conradtspang/MarineCollectionVessel/01_Documentation/07_MarineCollectionVessel_Electronics_Design.pdf

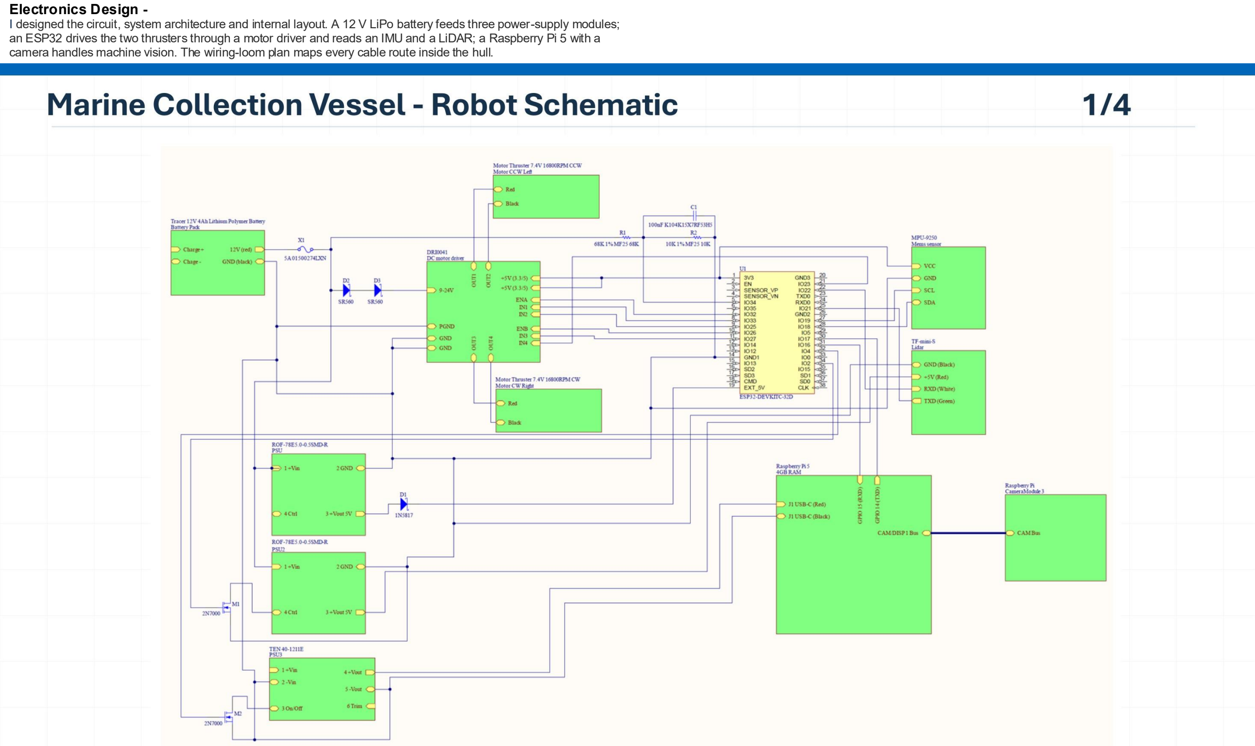
[picture p2: page 1]

Electronics Design -
I designed the circuit, system architecture and internal layout. A 12 V LiPo battery feeds three power-supply modules; an ESP32 drives the two thrusters through a motor driver and reads an IMU and a LiDAR; a Raspberry Pi 5 with a camera handles machine vision. The wiring-loom plan maps every cable route inside the hull.

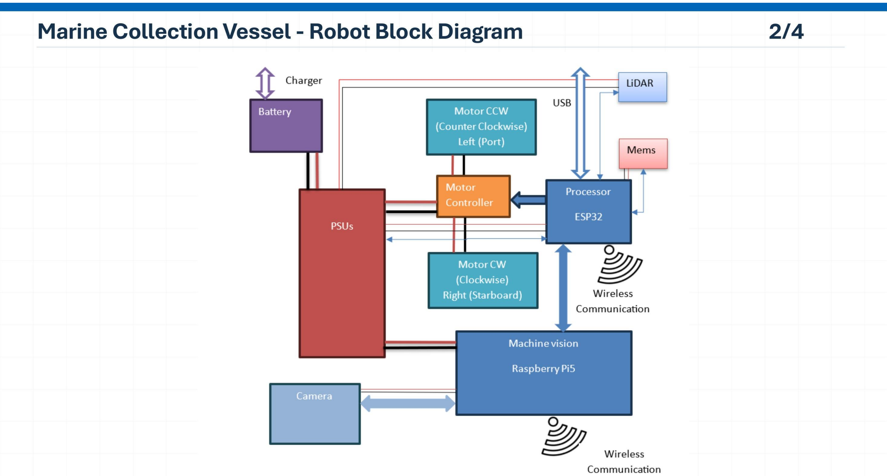
[picture p3: page 2]
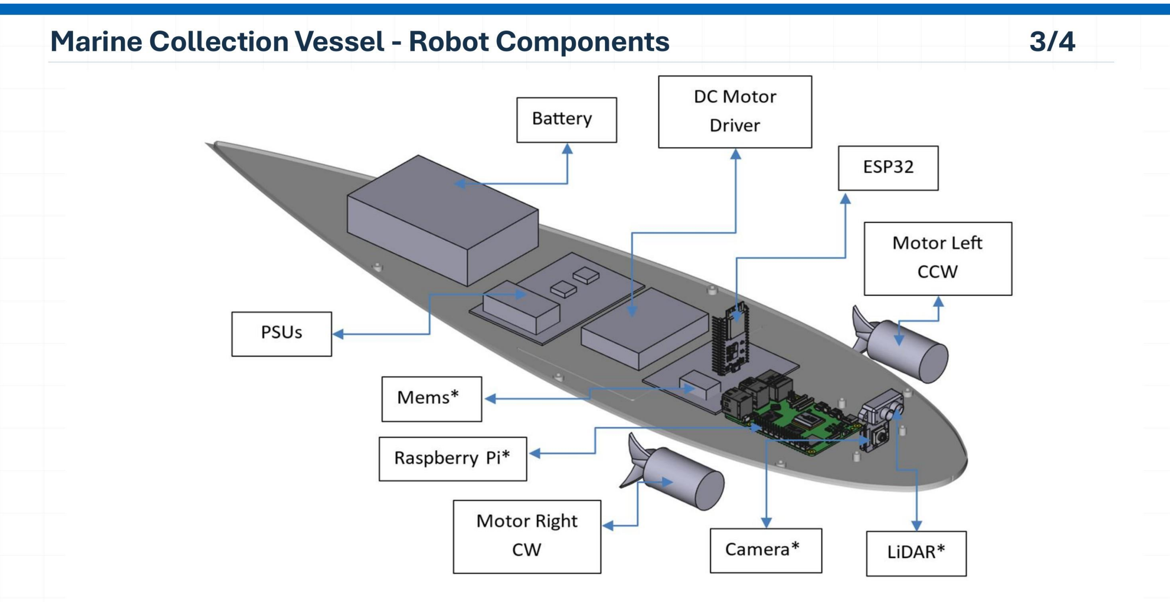
[picture p4: page 3]
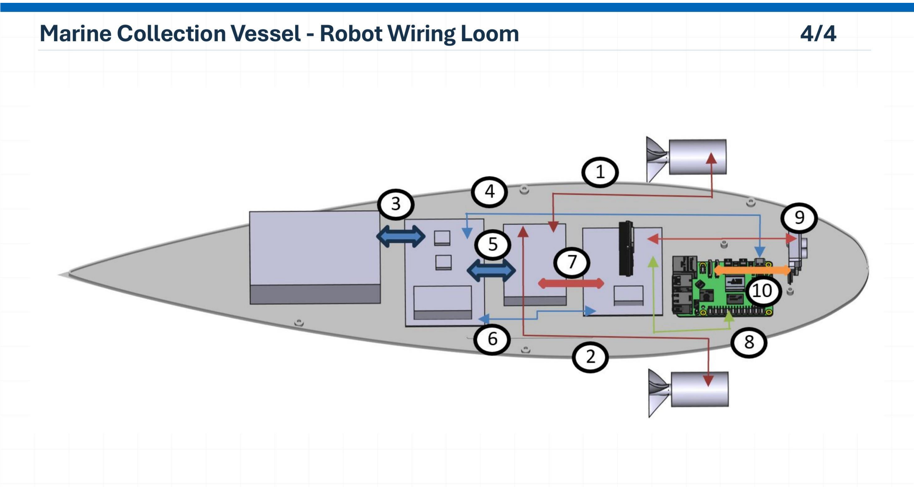
[picture p5: page 4]
