conradtspang/MarineCollectionVessel/03_Electronics/BOM.md

  <h1>Bill of materials</h1>
<center>
<table>
  <tr>
    <th>Part</th>
    <th>Model</th>
    <th>Qty</th>
    <th>Purpose</th>
  </tr>
  <tr>
    <td>Battery</td>
    <td>Tracer 12V 4Ah LiPo</td>
    <td>1</td>
    <td>Main power</td>
  </tr>
  <tr>
    <td>Fuse</td>
    <td>5A</td>
    <td>1</td>
    <td>Battery protection</td>
  </tr>
  <tr>
    <td>Diode</td>
    <td>SR560</td>
    <td>2</td>
    <td>Reduce voltage for motor driver</td>
  </tr>
 <tr>
    <td>Motor driver</td>
    <td>DRV8841 dual DC motor driver</td>
    <td>1</td>
    <td>Drives both thrusters</td>
  </tr>
  <tr>
    <td>Microcontroller</td>
    <td>ESP32 DevKit V1</td>
    <td>1</td>
    <td>Vessel control, ESP-NOW</td>
  </tr>
    <tr>
    <td>PSU</td>
    <td>ROF-78E5.0-0.5SMD-R</td>
    <td>2</td>
    <td>5V supply rails</td>
  </tr>
      <tr>
    <td>Shortky Diode</td>
    <td>1N5817</td>
    <td>1</td>
    <td>Protect PSU from USB voltage</td>
  </tr>
    <tr>
    <td>PSU</td>
    <td>TEN40-1211E</td>
    <td>1</td>
    <td>Raspberry Pi supply (phase 2)</td>
  </tr>
    <tr>
    <td>MOSFET</td>
    <td>2N7000</td>
    <td>2</td>
    <td>Switch power rails on/off</td>
  </tr>
      <tr>
    <td>Resistor</td>
    <td>68k</td>
    <td>1</td>
    <td>Divider bridge to monitor battery voltage</td>
  </tr>
      <tr>
    <td>Resistor</td>
    <td>10k</td>
    <td>1</td>
    <td>Divider bridge to monitor battery voltage</td>
  </tr>
      <tr>
    <td>Capacitor</td>
    <td>100nF</td>
    <td>2</td>
    <td>Low pass filter to monitor battery voltage</td>
  </tr>
    <tr>
    <td>Thrusters</td>
    <td>7.4V 16800 RPM,3-blade (1 CW, 1CCW)</td>
    <td>2</td>
    <td>Propulsion</td>
  </tr>
    <tr>
    <td>Remote controller</td>
    <td>pyController</td>
    <td>1</td>
    <td>Handheld control</td>
  </tr>
   <tr>
    <td colspan="4"><b>Phase 2 (planned)</b></td>

  </tr>
      <tr>
    <td>LiDAR</td>
    <td>TFmini-S</td>
    <td>1</td>
    <td>Obstacle detection</td>
  </tr>
        <tr>
    <td>IMU</td>
    <td>MPU-9250</td>
    <td>1</td>
    <td>Heading and orientation</td>
  </tr>
          <tr>
    <td>Vision processor</td>
    <td>Raspberry Pi 5, 4GB</td>
    <td>1</td>
    <td>YOLO detection</td>
  </tr>
          <tr>
    <td>Camera</td>
    <td>Raspberry Pi Camera Module 3</td>
    <td>1</td>
    <td>Video capture</td>
  </tr>
</table>
</center>
