conradtspang/MarineCollectionVessel/02_3D_Print_Files/Lattice_Box/no.20-1012503_3 Latticebox-05 FrontCornerLeft.15.12.25.stl

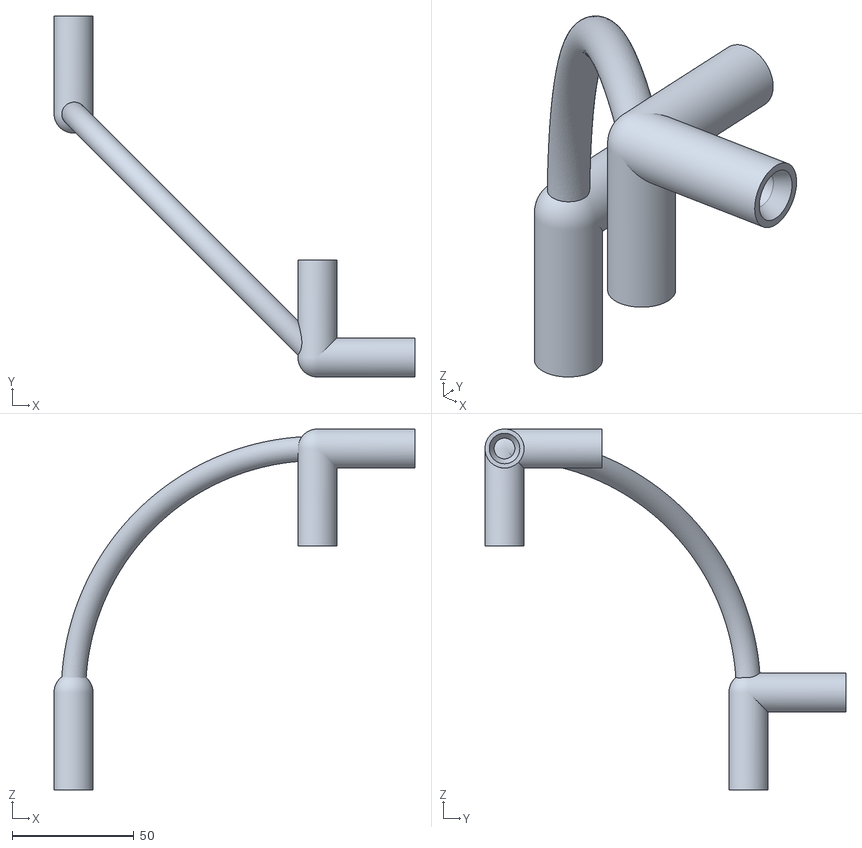
[picture p6: CAD file, 2026-09-25]
02_3D_Print_Files/Lattice_Box/no.20-1012503_3 Latticebox-05 FrontCornerLeft.15.12.25.stl
148.0 x 148.0 x 148.0
