conradtspang/MarineCollectionVessel/02_3D_Print_Files/Net/no.14-1012503 Robot Mod Rev1.10-15NetAttachment.15.12.25.stl

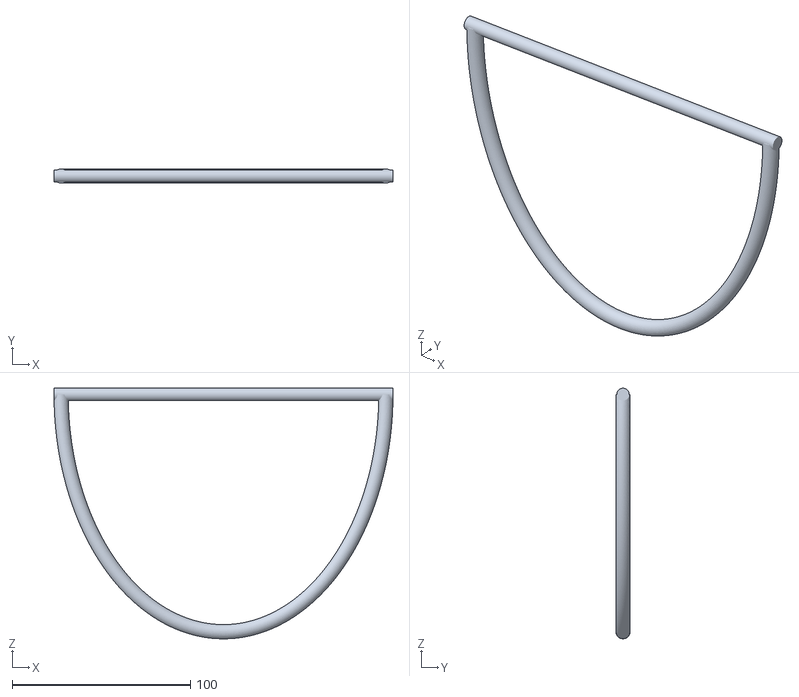
[picture p7: CAD file, 2026-09-25]
02_3D_Print_Files/Net/no.14-1012503 Robot Mod Rev1.10-15NetAttachment.15.12.25.stl
190.0 x 8.00 x 140.5
