conradtspang/MarineCollectionVessel/02_3D_Print_Files/no.13-1012503 Robot Mod Rev1.20-14Mouth.15.12.25.stl

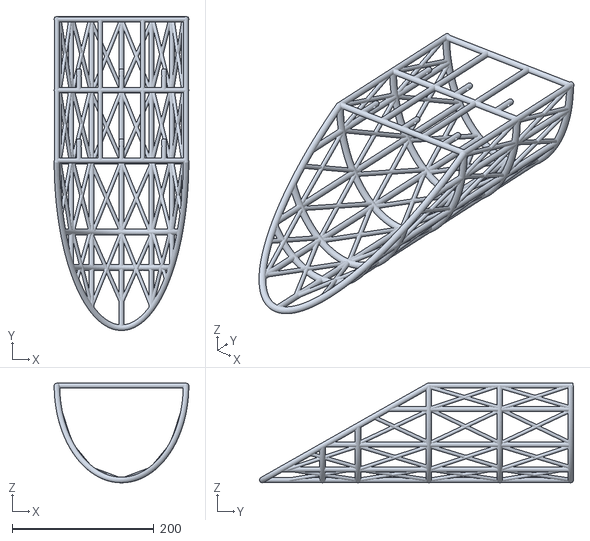
[picture p8: CAD file, 2026-09-25]
02_3D_Print_Files/no.13-1012503 Robot Mod Rev1.20-14Mouth.15.12.25.stl
190.0 x 443.0 x 140.5
