conradtspang/MarineCollectionVessel/02_3D_Print_Files/Lattice_Box/no.21-1012503_3 Latticebox-06 FrontBottomCornerRight.15.12.25.stl

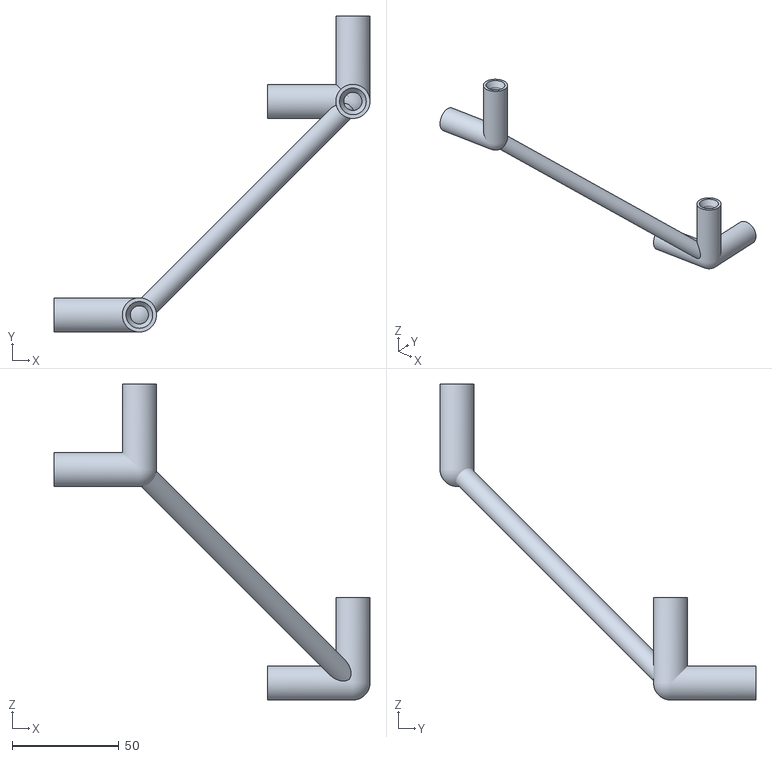
[picture p9: CAD file, 2026-09-25]
02_3D_Print_Files/Lattice_Box/no.21-1012503_3 Latticebox-06 FrontBottomCornerRight.15.12.25.stl
148.0 x 148.0 x 148.0
