conradtspang/MarineCollectionVessel/02_3D_Print_Files/no.11-1012503 Robot Mod Rev1.10-12SupportL.15.12.25.stl

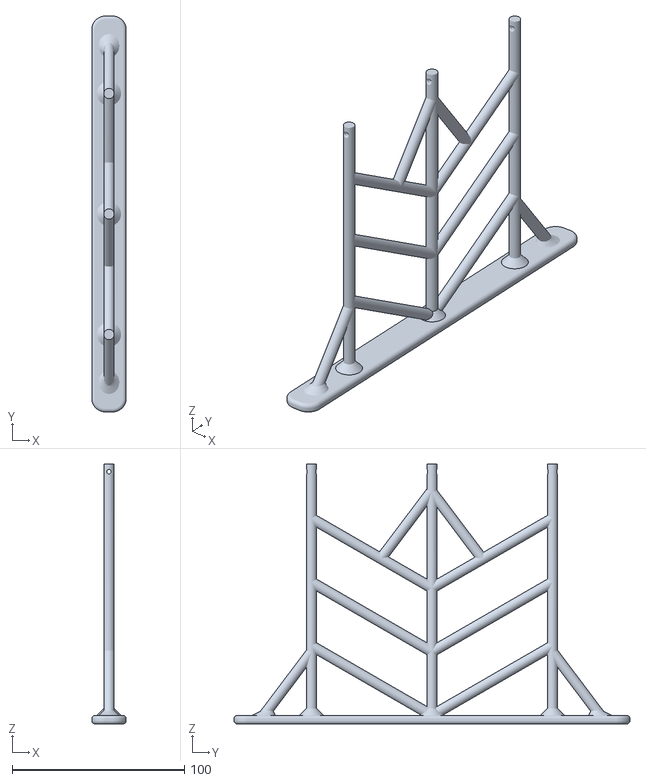
[picture p10: CAD file, 2026-09-25]
02_3D_Print_Files/no.11-1012503 Robot Mod Rev1.10-12SupportL.15.12.25.stl
20.0 x 230.0 x 151.0
