conradtspang/MarineCollectionVessel/02_3D_Print_Files/Lattice_Box/no.23-1012503_3 Latticebox-08 CornerX2.15.12.25.stl

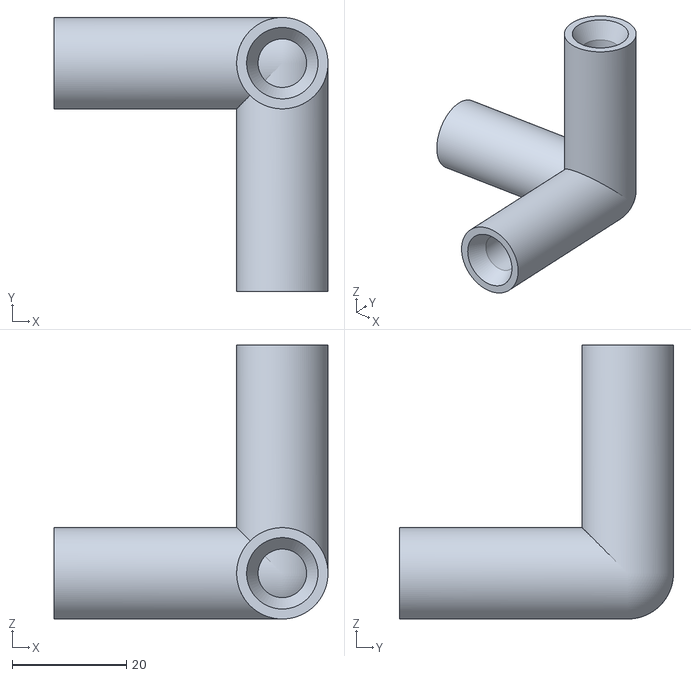
[picture p11: CAD file, 2026-09-25]
02_3D_Print_Files/Lattice_Box/no.23-1012503_3 Latticebox-08 CornerX2.15.12.25.stl
48.0 x 48.0 x 48.0
