conradtspang/MarineCollectionVessel/02_3D_Print_Files/no.10-1012503 Robot Mod Rev1.0-11FloatBottomR.15.12.25.stl

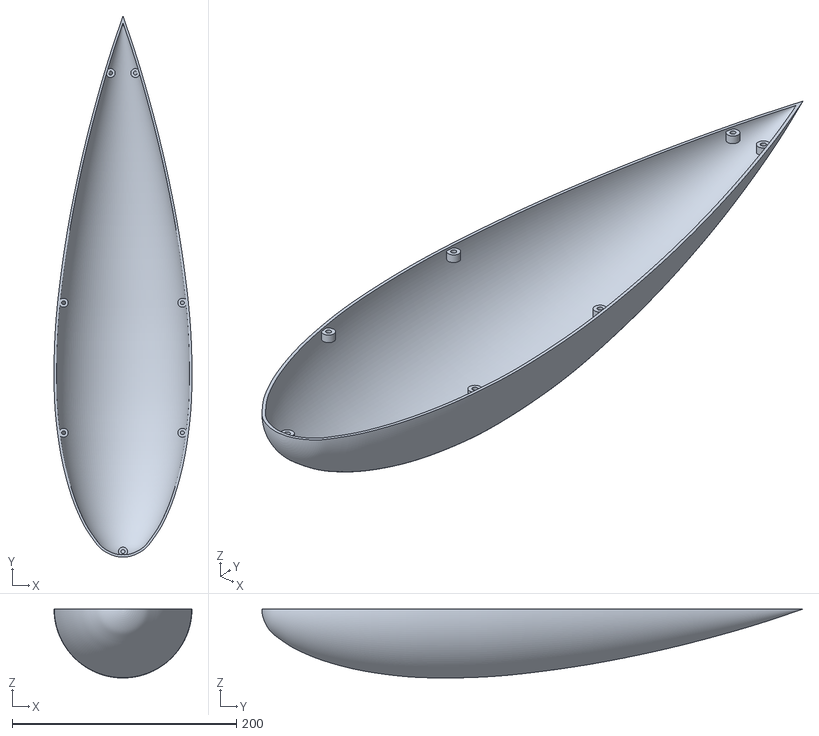
[picture p12: CAD file, 2026-09-25]
02_3D_Print_Files/no.10-1012503 Robot Mod Rev1.0-11FloatBottomR.15.12.25.stl
123.1 x 482.7 x 61.6
