conradtspang/MarineCollectionVessel/02_3D_Print_Files/no.08-1012503 Robot Mod Rev1.0-09FloatTopR.15.12.25.stl

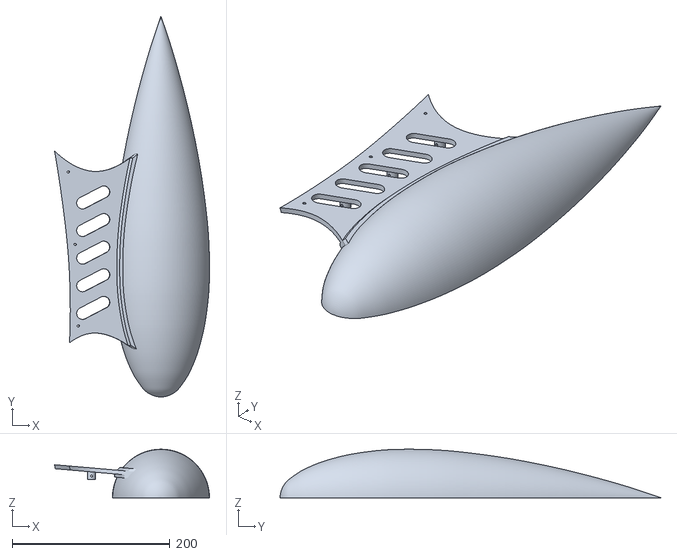
[picture p13: CAD file, 2026-09-25]
02_3D_Print_Files/no.08-1012503 Robot Mod Rev1.0-09FloatTopR.15.12.25.stl
196.5 x 482.7 x 61.6
