conradtspang/MarineCollectionVessel/02_3D_Print_Files/no.06-1012503 Robot Mod Rev1.0-07MotorR.15.12.25.stl

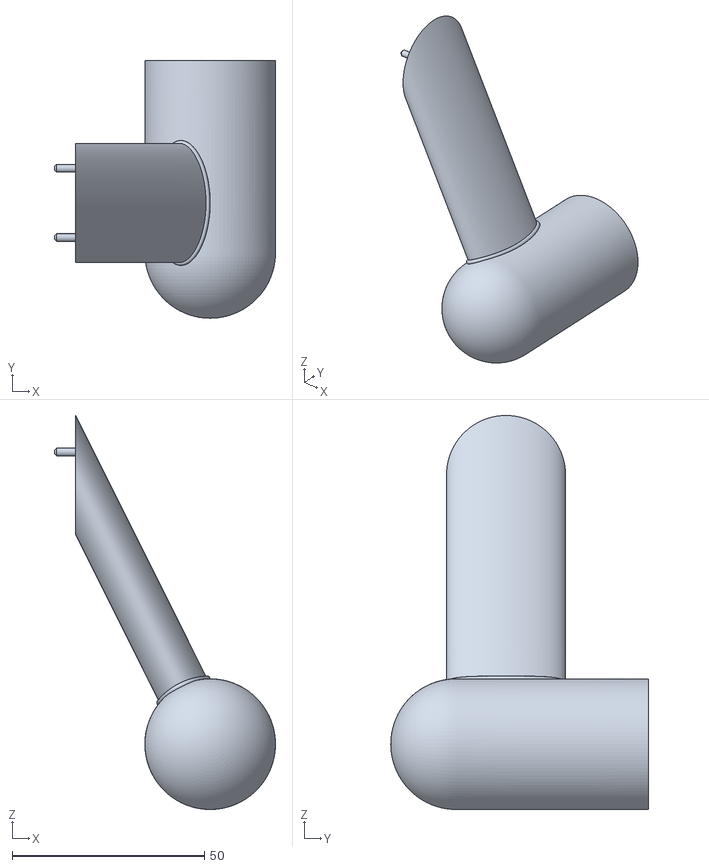
[picture p14: CAD file, 2026-09-25]
02_3D_Print_Files/no.06-1012503 Robot Mod Rev1.0-07MotorR.15.12.25.stl
57.5 x 67.0 x 102.5
