conradtspang/MarineCollectionVessel/02_3D_Print_Files/Lattice_Box/no.24-1012503_3 Latticebox-09 MiddleX2.15.12.25.stl

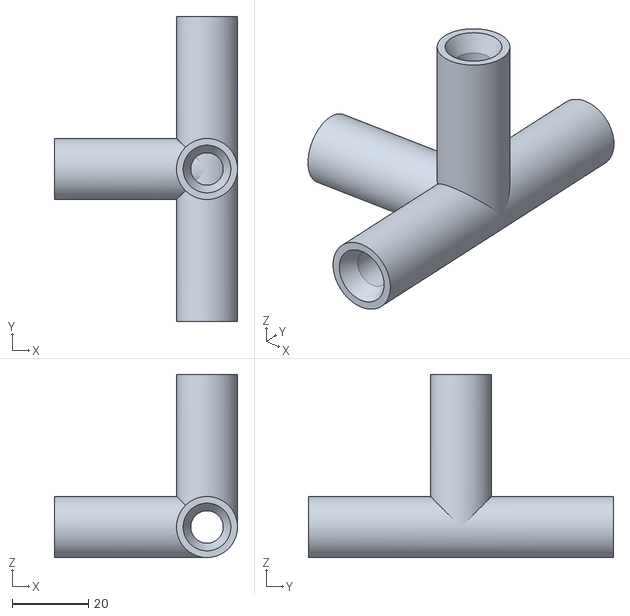
[picture p15: CAD file, 2026-09-25]
02_3D_Print_Files/Lattice_Box/no.24-1012503_3 Latticebox-09 MiddleX2.15.12.25.stl
48.0 x 80.0 x 48.0
