conradtspang/MarineCollectionVessel/02_3D_Print_Files/no.04-1012503 Robot Mod Rev1.10-05BottomPlate.15.12.25.stl

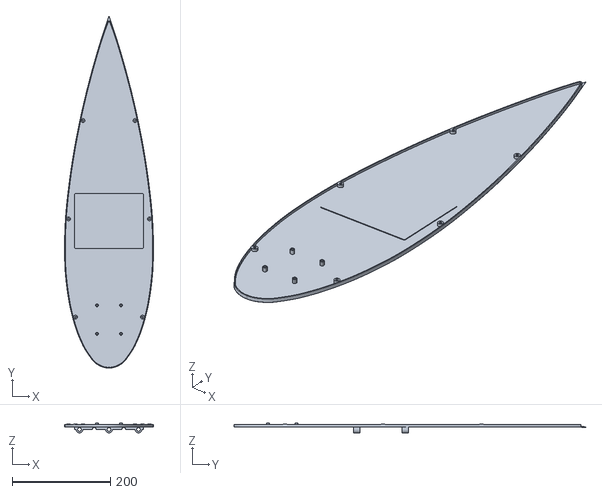
[picture p17: CAD file, 2026-09-25]
02_3D_Print_Files/no.04-1012503 Robot Mod Rev1.10-05BottomPlate.15.12.25.stl
181.0 x 716.8 x 20.0
