conradtspang/MarineCollectionVessel/02_3D_Print_Files/Lattice_Box/no.15-1012503 Robot Mod Rev1.20-16LatticeBoxAttatchment.15.12.25.stl

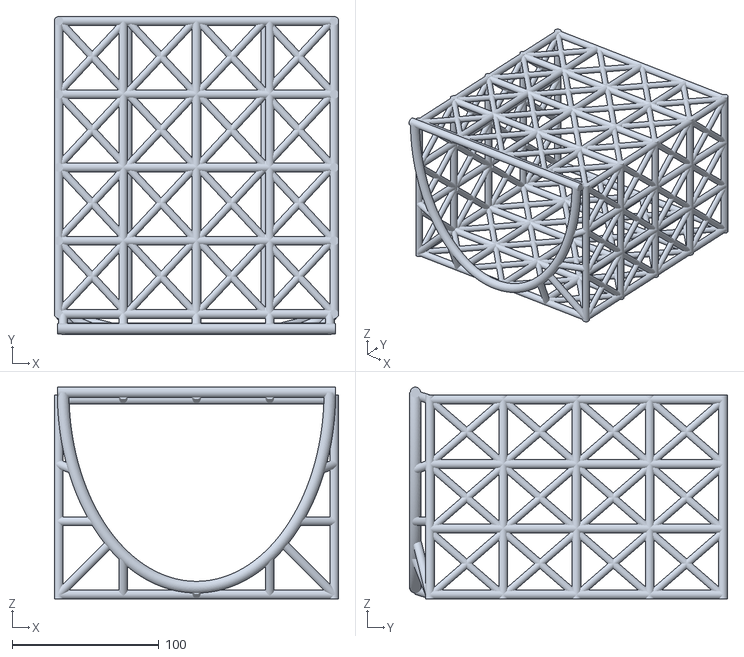
[picture p18: CAD file, 2026-09-25]
02_3D_Print_Files/Lattice_Box/no.15-1012503 Robot Mod Rev1.20-16LatticeBoxAttatchment.15.12.25.stl
194.0 x 217.0 x 144.5
