conradtspang/MarineCollectionVessel/02_3D_Print_Files/no.03-1012503 Robot Mod Rev1.0-04see_through_panel.15.12.25.stl

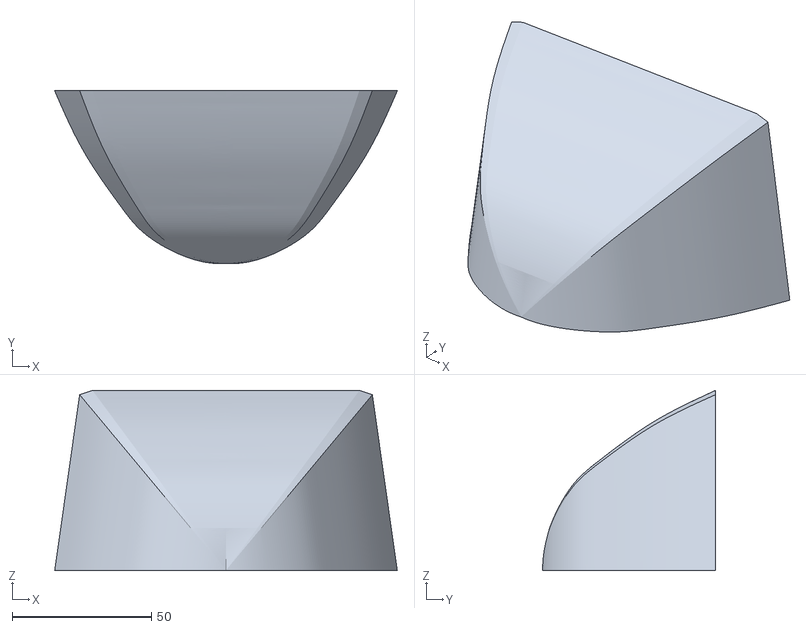
[picture p19: CAD file, 2026-09-25]
02_3D_Print_Files/no.03-1012503 Robot Mod Rev1.0-04see_through_panel.15.12.25.stl
123.1 x 62.1 x 64.7
