conradtspang/MarineCollectionVessel/02_3D_Print_Files/no.02-1012503 Robot Mod Rev1.0-03Housing.15.12.25.stl

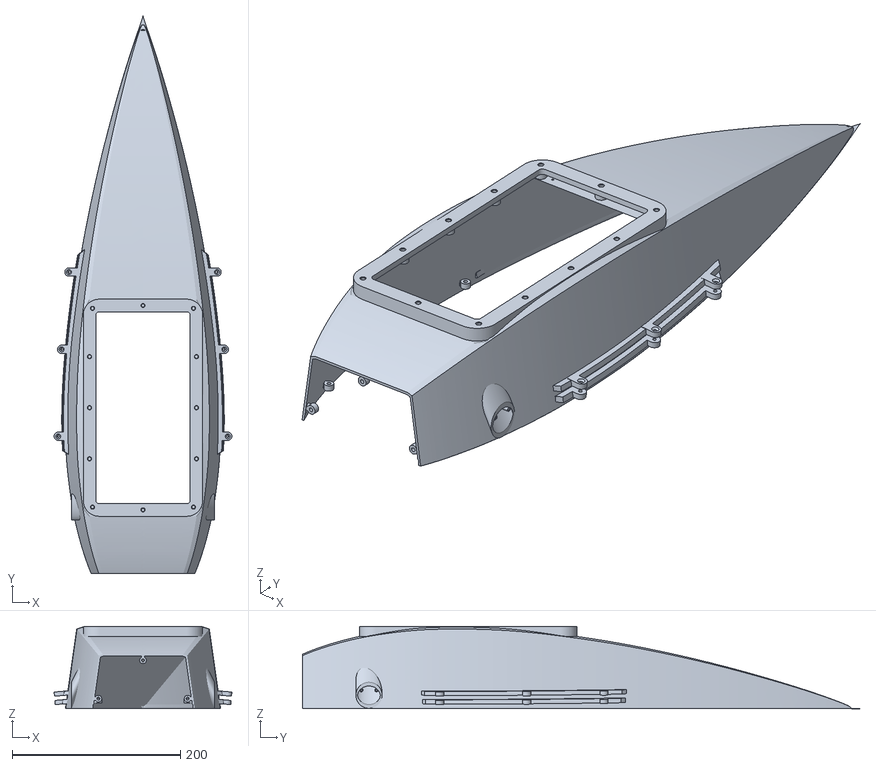
[picture p20: CAD file, 2026-09-25]
02_3D_Print_Files/no.02-1012503 Robot Mod Rev1.0-03Housing.15.12.25.stl
211.4 x 661.9 x 98.0
