conradtspang/MarineCollectionVessel/02_3D_Print_Files/no.01-1012503 Robot Mod Rev1.0-01Lid.15.12.25.stl

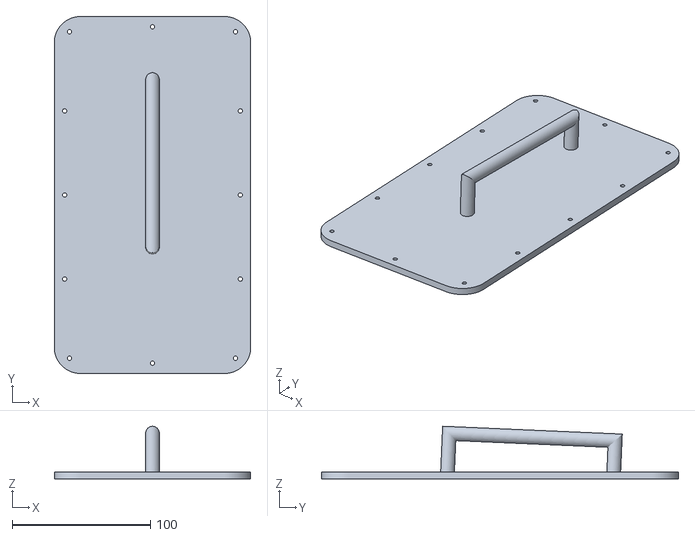
[picture p21: CAD file, 2026-09-25]
02_3D_Print_Files/no.01-1012503 Robot Mod Rev1.0-01Lid.15.12.25.stl
142.0 x 258.0 x 38.0
