conradtspang/MarineCollectionVessel/(list of files, cad)

Other CAD files:
02_3D_Print_Files/Lattice_Box/no.16-1012503_3 Latticebox-01 EndCornerRight.15.12.25.stl
02_3D_Print_Files/no.09-1012503 Robot Mod Rev1.0-10FloatBottomL.15.12.25.stl
02_3D_Print_Files/Lattice_Box/no.19-1012503_3 Latticebox-04 FrontCornerRight.15.12.25.stl
02_3D_Print_Files/Lattice_Box/no.22-1012503_3 Latticebox-07 FrontBottomCornerLeft.15.12.25.stl
02_3D_Print_Files/no.07-1012503 Robot Mod Rev1.0-08FloatTopL.15.12.25.stl
02_3D_Print_Files/Lattice_Box/no.17-1012503_3 Latticebox-02 EndCornerLeft.15.12.25.stl
02_3D_Print_Files/no.05-1012503 Robot Mod Rev1.0-06MotorL.15.12.25.stl
