conradtspang/MarineCollectionVessel/02_3D_Print_Files/README.md

<div align="center">
    <h1>Marine Collection Vessel 3D Print Files</h1>
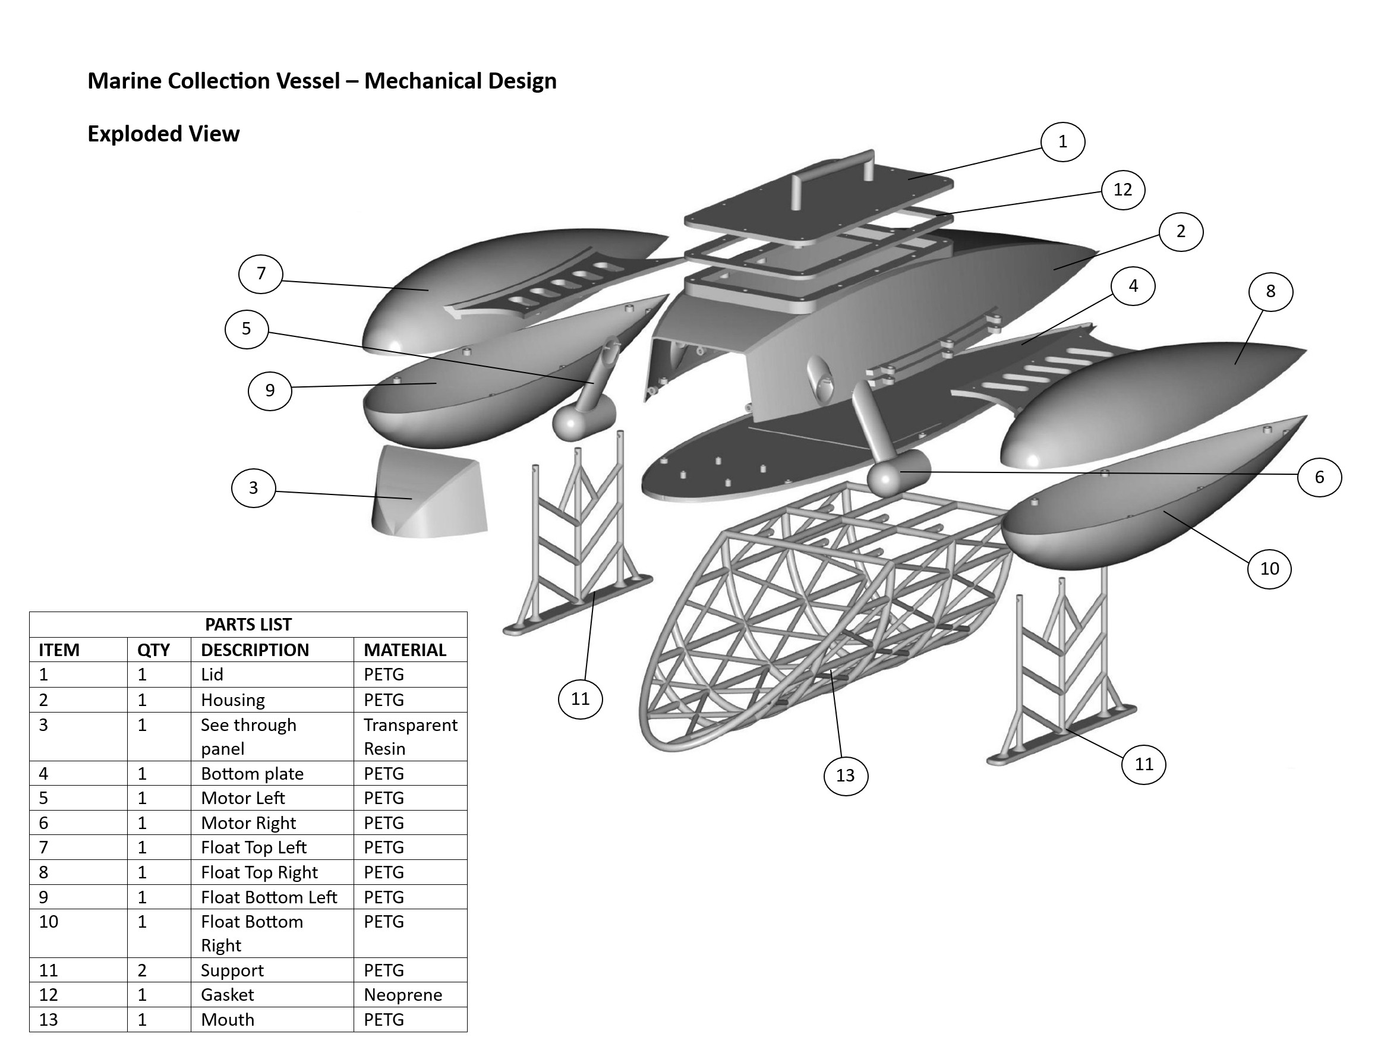
[picture p22: 02_3D_Print_Files/MarineCollectionVesselExplodedView.jpg]
Marine Collection Vessel Exploded view
  

</div>
