conradtspang/MarineCollectionVessel/(commit log)

2026-09-25 Rename no.01-1012503 Robot Mod Rev1.0-01Lid.15.12.25.stl to 02_3D_Print_Files/no.01-1012503 Robot Mod Rev1.0-01Lid.15.12.25.stl
    Lid of the Marine Collection Vessel
    Material: PETG
    Infull: 100% need to be waterproof
    Colour: Light Grey
    [no.01-1012503 Robot Mod Rev1.0-01Lid.15.12.25.stl]
2026-09-25 Add files via upload
    Housing of the Marine Collection Vessel
    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
    [no.02-1012503 Robot Mod Rev1.0-03Housing.15.12.25.stl]
2026-09-25 Add files via upload
    See Through Panel of the Marine Collection Vessel
    Material: Resin
    Colour: Transparent
    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
    [no.03-1012503 Robot Mod Rev1.0-04see_through_panel.15.12.25.stl]
2026-09-25 Add files via upload
    Bottom Plate of the Marine Collection Vessel
    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
    [no.04-1012503 Robot Mod Rev1.10-05BottomPlate.15.12.25.stl]
2026-09-25 Add files via upload
    Left Motor of the Marine Collection Vessel
    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
    [no.05-1012503 Robot Mod Rev1.0-06MotorL.15.12.25.stl]
2026-09-25 Add files via upload
    Right Motor of the Marine Collection Vessel
    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
    [no.06-1012503 Robot Mod Rev1.0-07MotorR.15.12.25.stl]
2026-09-25 Add files via upload
    Left Float Top of the Marine Collection Vessel
    Infill: 100% need to be waterproof
    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
    [no.07-1012503 Robot Mod Rev1.0-08FloatTopL.15.12.25.stl]
2026-09-25 Add files via upload
    Right Float Top of the Marine Collection Vessel
    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
    [no.08-1012503 Robot Mod Rev1.0-09FloatTopR.15.12.25.stl]
2026-09-25 Add files via upload
    Left Float Bottom of the Marine Collection Vessel
    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
    [no.09-1012503 Robot Mod Rev1.0-10FloatBottomL.15.12.25.stl]
2026-09-25 Add files via upload
    Right Float Bottom of the Marine Collection Vessel
    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
    [no.10-1012503 Robot Mod Rev1.0-11FloatBottomR.15.12.25.stl]
2026-09-25 Add files via upload
    Left and Right Support of the Marine Collection Vessel
    Infill: 100%
    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
    [no.11-1012503 Robot Mod Rev1.10-12SupportL.15.12.25.stl]
2026-09-25 Add files via upload
    Mouth of the Marine Collection Vessel
    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
    [no.13-1012503 Robot Mod Rev1.20-14Mouth.15.12.25.stl]
2026-09-25 Rename 02_3D_Print_Files/no.14-1012503 Robot Mod Rev1.10-15NetAttachment.15.12.25.stl to 02_3D_Print_Files/Net/no.14-1012503 Robot Mod Rev1.10-15NetAttachment.15.12.25.stl
    Net Attachment
    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
    [no.14-1012503 Robot Mod Rev1.10-15NetAttachment.15.12.25.stl]
2026-09-25 Rename no.14-1012503 Robot Mod Rev1.10-15NetAttachment.15.12.25.stl to Robot Mod Rev1.10-15NetAttachment.15.12.25.stl
    [Robot Mod Rev1.10-15NetAttachment.15.12.25.stl]
2026-09-25 Add files via upload
    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
    [no.14-1012503 Robot Mod Rev1.10-15NetAttachment.15.12.25.stl]
2026-09-25 Add files via upload
    Lattice Box Attachment
    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
    [no.15-1012503 Robot Mod Rev1.20-16LatticeBoxAttatchment.15.12.25.stl]
2026-09-25 Rename 02_3D_Print_Files/no.15-1012503 Robot Mod Rev1.20-16LatticeBoxAttatchment.15.12.25.stl to 02_3D_Print_Files/Lattice_Box/15-1012503 Robot Mod Rev1.20-16LatticeBoxAttatchment.15.12.25.stl
    [15-1012503 Robot Mod Rev1.20-16LatticeBoxAttatchment.15.12.25.stl, no.15-1012503 Robot Mod Rev1.20-16LatticeBoxAttatchment.15.12.25.stl]
2026-09-25 Add files via upload
    Lattice Box Connectors
    Material: Nylon
    Colour: Grey
    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
    [no.16-1012503_3 Latticebox-01 EndCornerRight.15.12.25.stl, no.17-1012503_3 Latticebox-02 EndCornerLeft.15.12.25.stl, no.18-1012503_3 Latticebox-03 MiddleCurveX2.15.12.25.stl, no.19-1012503_3 Latticebox-04 FrontCornerRight.15.12.25.stl, no.20-1012503_3 Latticebox-05 FrontCornerLeft.15.12.25.stl, no.21-1012503_3 Latticebox-06 FrontBottomCornerRight.15.12.25.stl, no.22-1012503_3 Latticebox-07 FrontB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]
2026-10-01 Add files via upload
    Full schematic, block diagram and wiring loom: Electronics Design (PDF)
2026-10-01 Rename 07_MarineCollectionVessel_Electronics_Design.pdf to 01_Documentation/07_MarineCollectionVessel_Electronics_Design.pdf
    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
2026-10-01 Create BOM.md
    Bill of materials
